lambdamikel/LambdaSpeak3/images/Computer_Shopper_-_December_2019-LS3.pdf

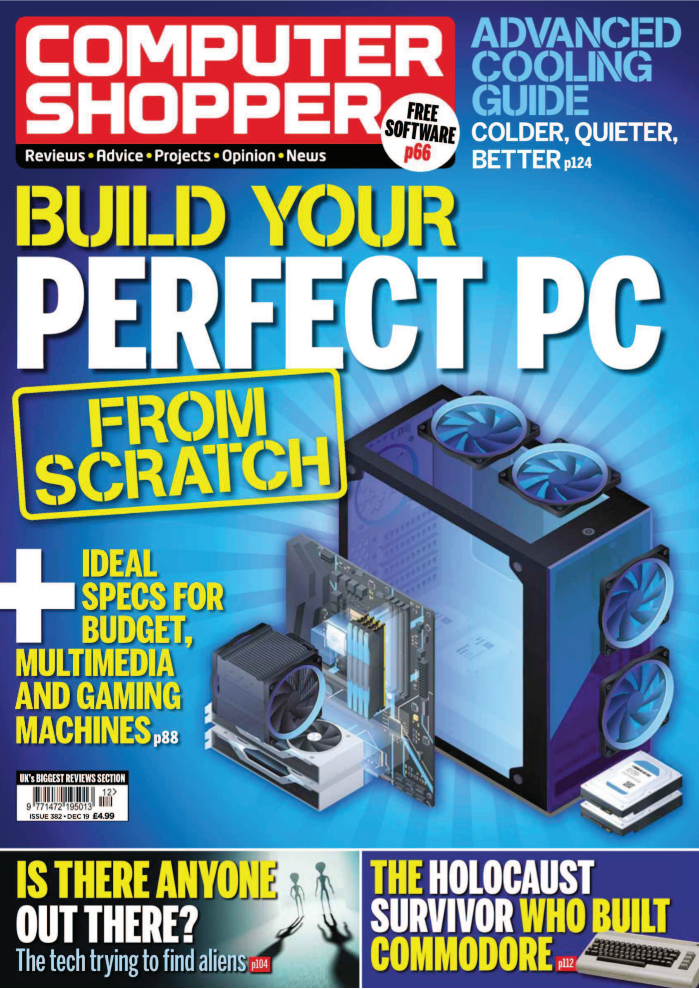
[picture p33: page 1]
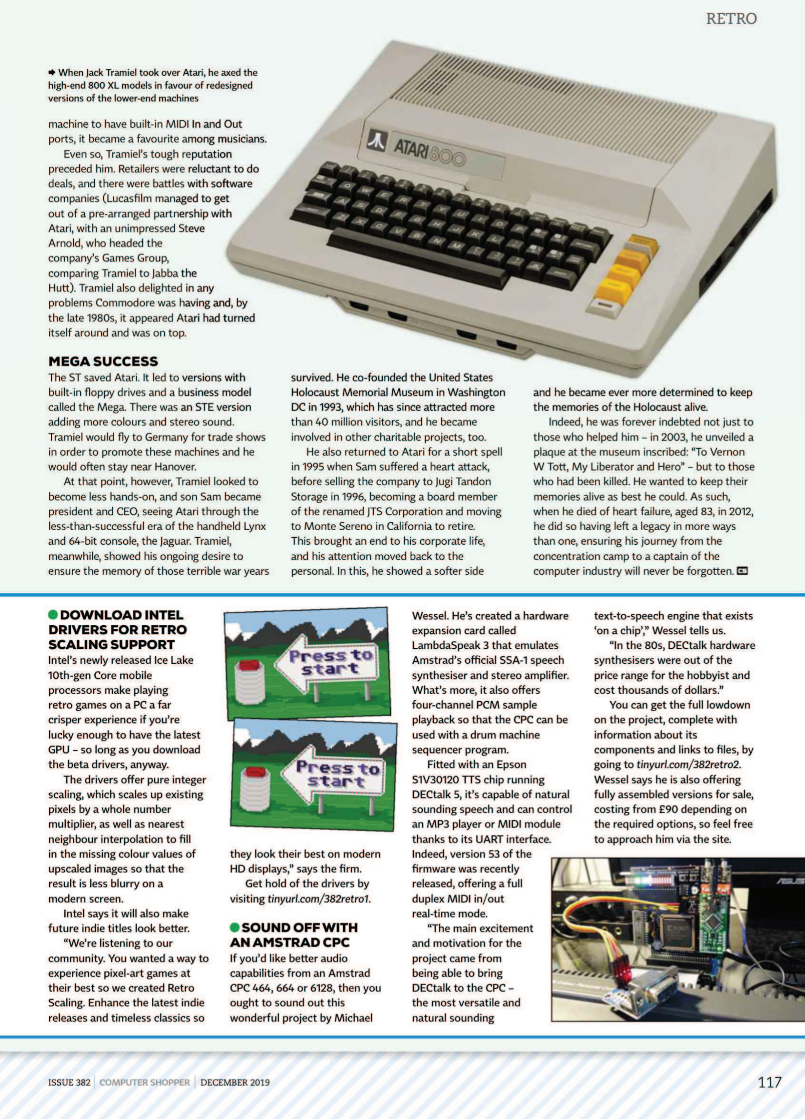
[picture p34: page 2]
