lambdamikel/LambdaSpeak3/articlepics/mycpc.jpg

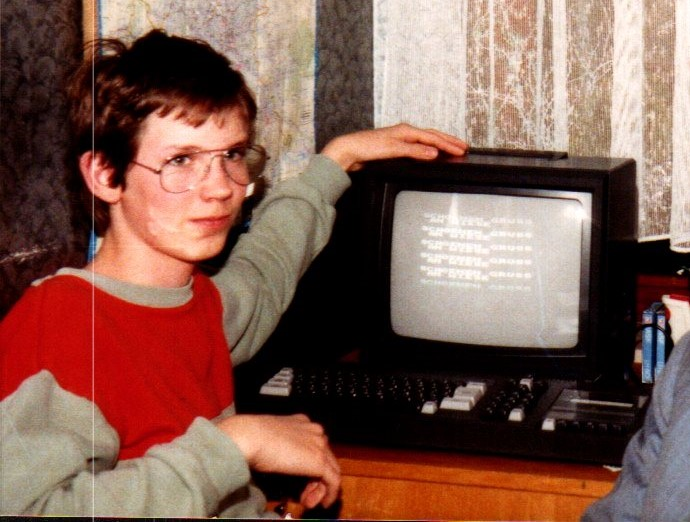
articlepics/mycpc.jpg
