lambdamikel/LambdaSpeak3/images/computershopper.jpg

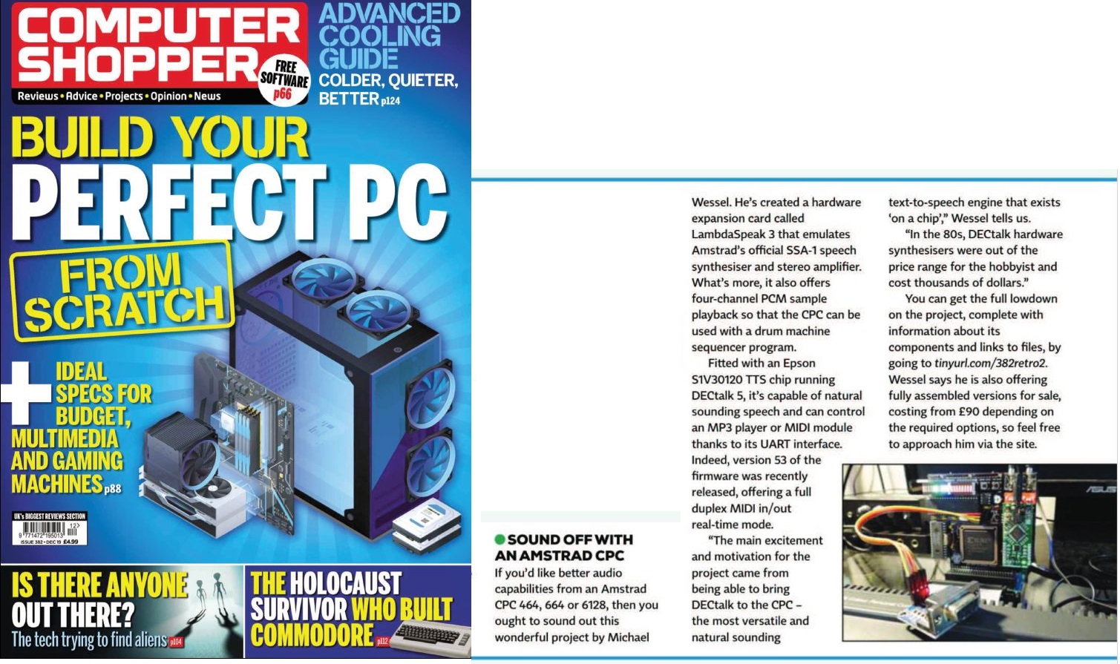
images/computershopper.jpg
