lambdamikel/LambdaSpeak3/images/DSC08523.JPG

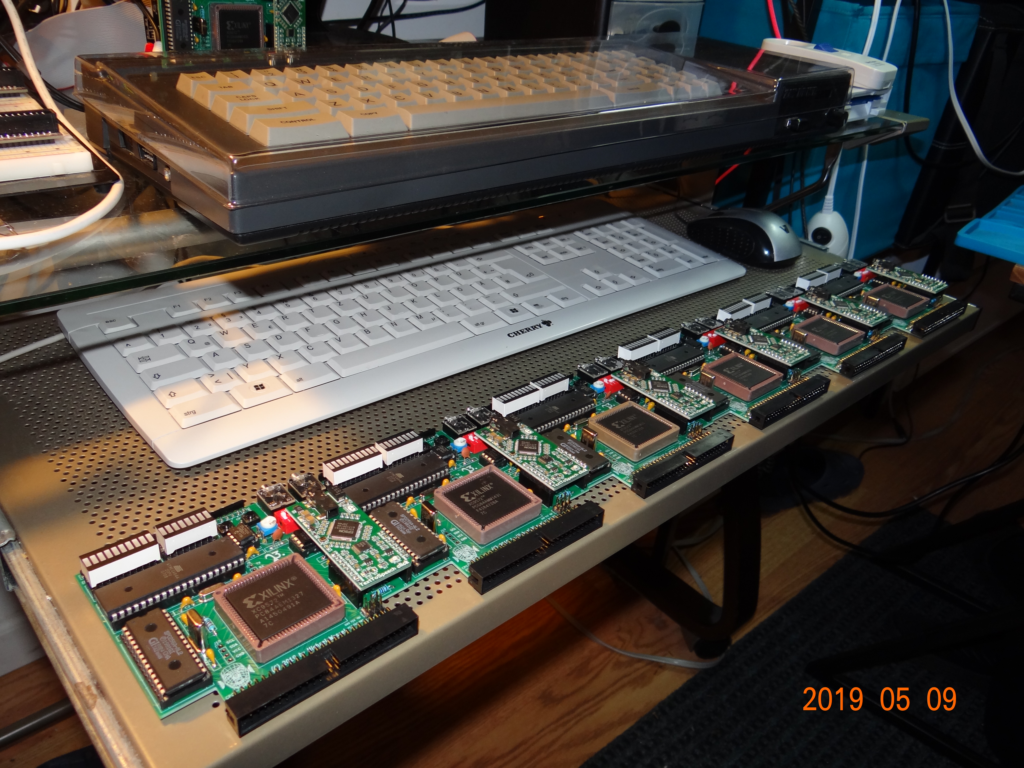
images/DSC08523.JPG
