lambdamikel/LambdaSpeak3/images/DSC08531.jpg

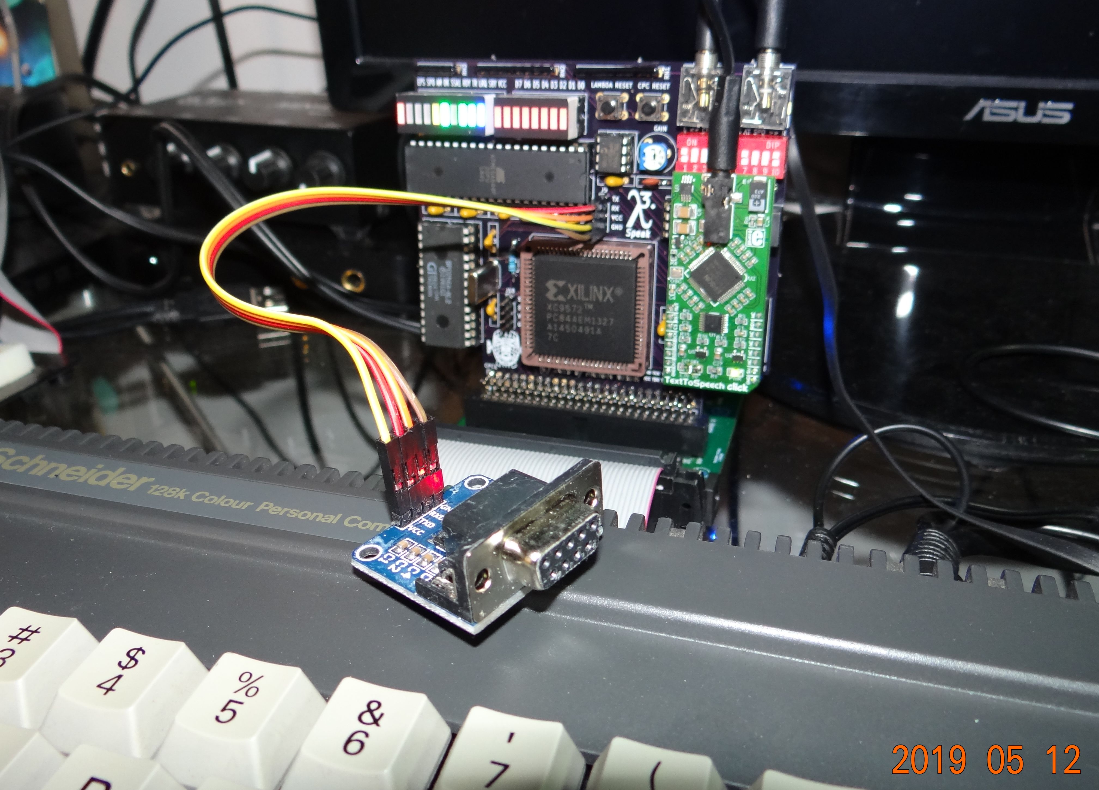
images/DSC08531.jpg
