lambdamikel/LambdaSpeak3/images/hackaday-ls3.jpg

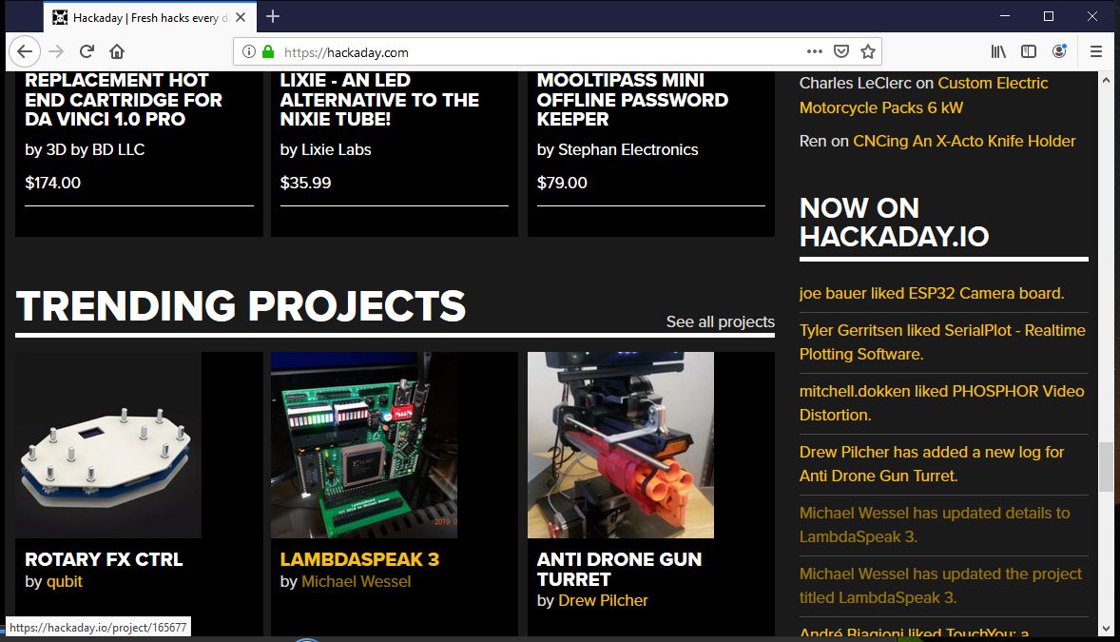
images/hackaday-ls3.jpg
