lambdamikel/LambdaSpeak3/images/lambdaspeak-z80-reset.jpg

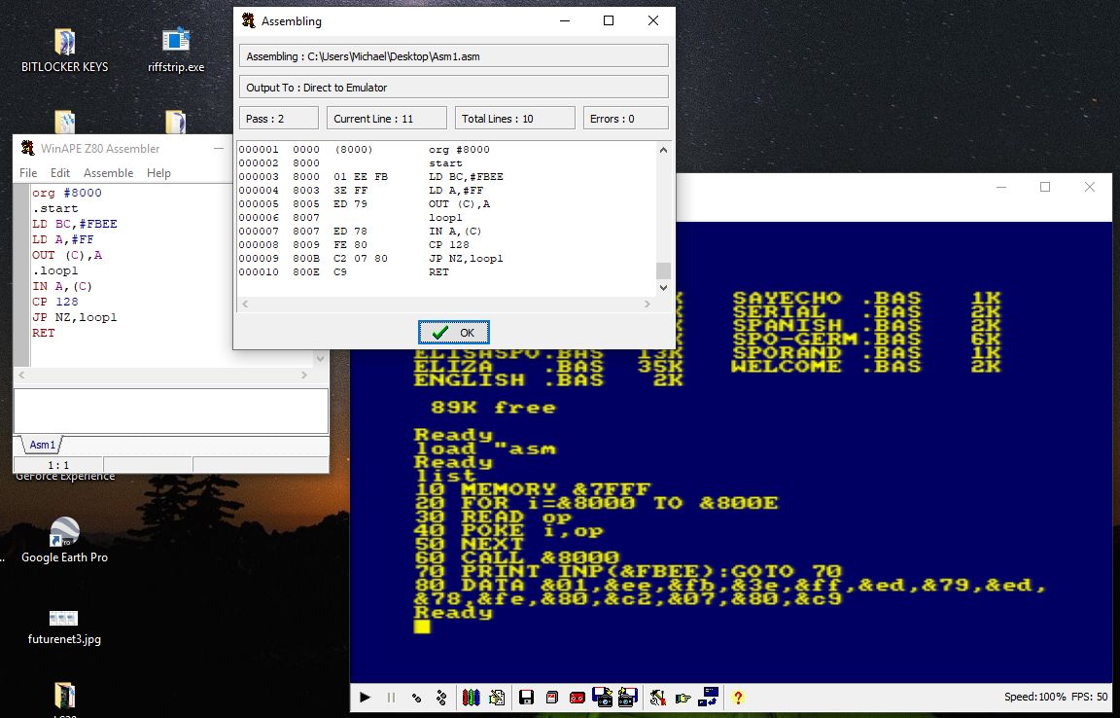
images/lambdaspeak-z80-reset.jpg
