lambdamikel/LambdaSpeak3/images/ls3-rtc-in-future-os.JPG

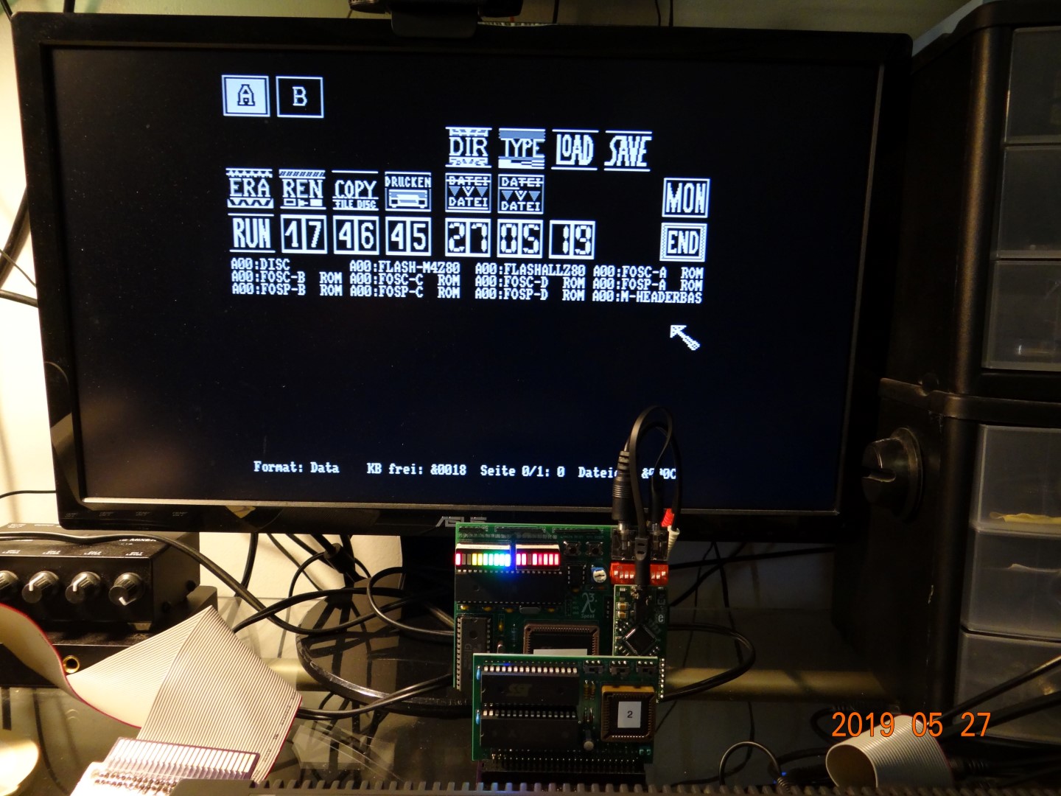
images/ls3-rtc-in-future-os.JPG
