lambdamikel/LambdaSpeak3/images/pcb-back.jpg

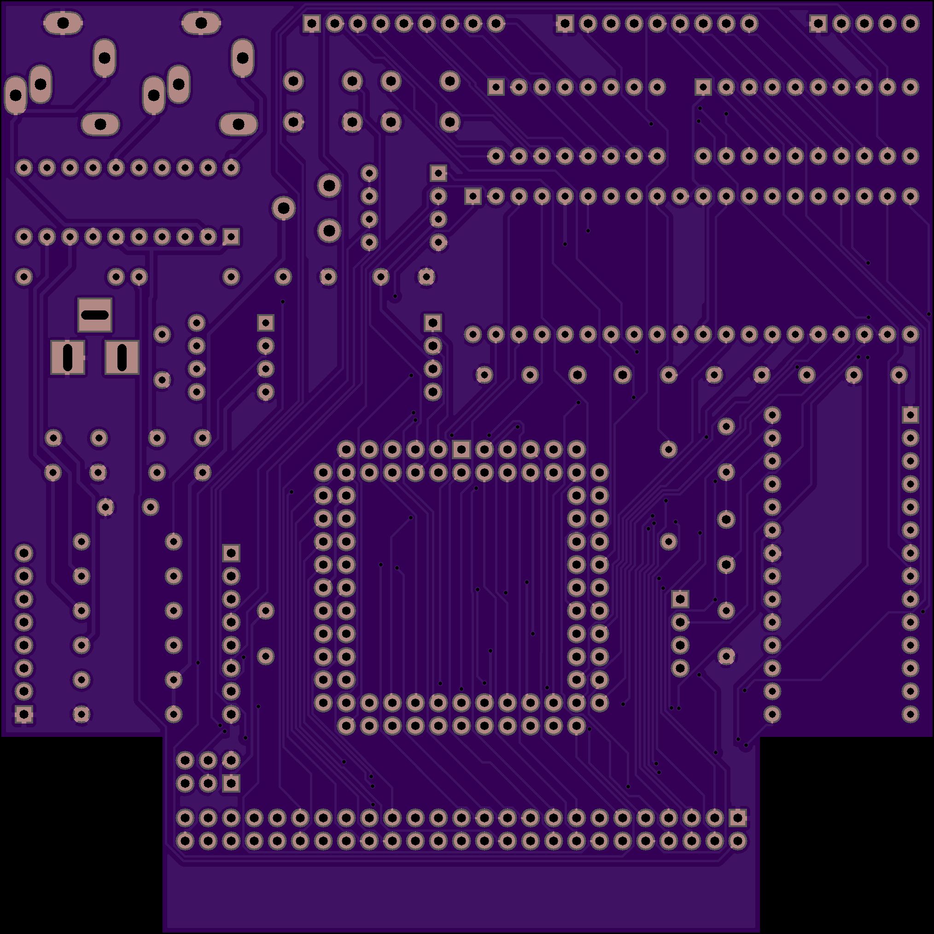
images/pcb-back.jpg
