lambdamikel/LambdaSpeak3/images/pcb-front.jpg

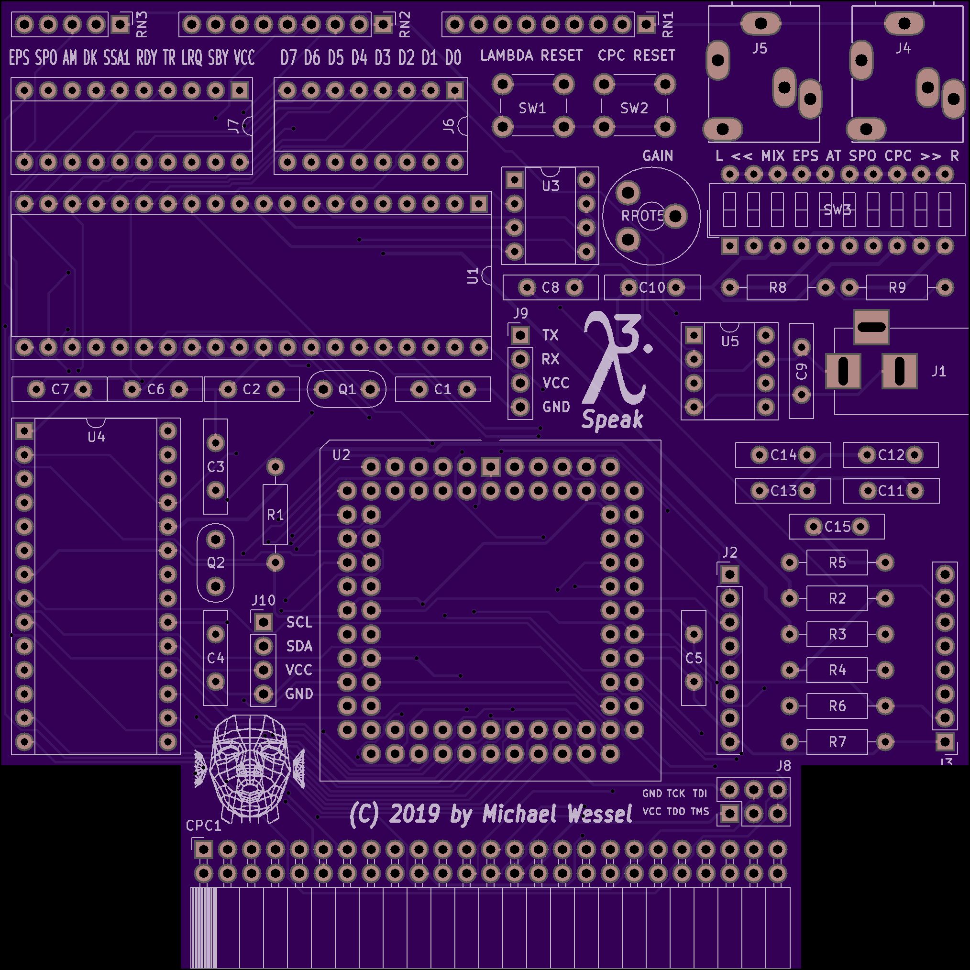
images/pcb-front.jpg
