lambdamikel/LambdaSpeak3/manuals/ls3-modes.pptx

RX / TX
IN OUT
MONITOR
SUB MODE

Reset Button,
Power Cycle

Serial Data OR
Control Byte =
255 + <byte>

SERIAL
MODE

&FF, 50

Serial Data OR
Control Byte =
255 + <byte>

&FF, 10

&F1

EPSON

RX
IN
MONITOR
SUB MODE

Don‘t Care
Input

AM-
DRUM

Streaming of PCM Bytes:
Byte -> PCM Audio

Receive Bytes:
> 127 : Control Byte
(change mode / setting)
<= 127 : Speech Content

Bytes: Hours,
Minutes, Seconds, …

SET RTC

&FF, &14

Return to
previous mode!

&E3

DECtalk

  1. modes in this group pairwise mutally reachable
  2. not all modes support all control bytes

&FF

&EF

SSA1 EMU

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
SSA1
SPO

End of mode / EOM
(all bytes received)

End of mode / EOM
(all bytes received)

Receive Bytes:
Address,
Sample Length,
then PCM Bytes
to store in EEPROM

&E1

&E2

&FA - &FD

PCM PLAY

Receive
PCM Play Commands:
Channel, Page, Pitch, Speed

PCM UPLOAD

&F1

Channel &FF
-> EXIT, return to
previous mode
