lambdamikel/LambdaSpeak3/manuals/ls3-modes.pdf

&E3

&F1

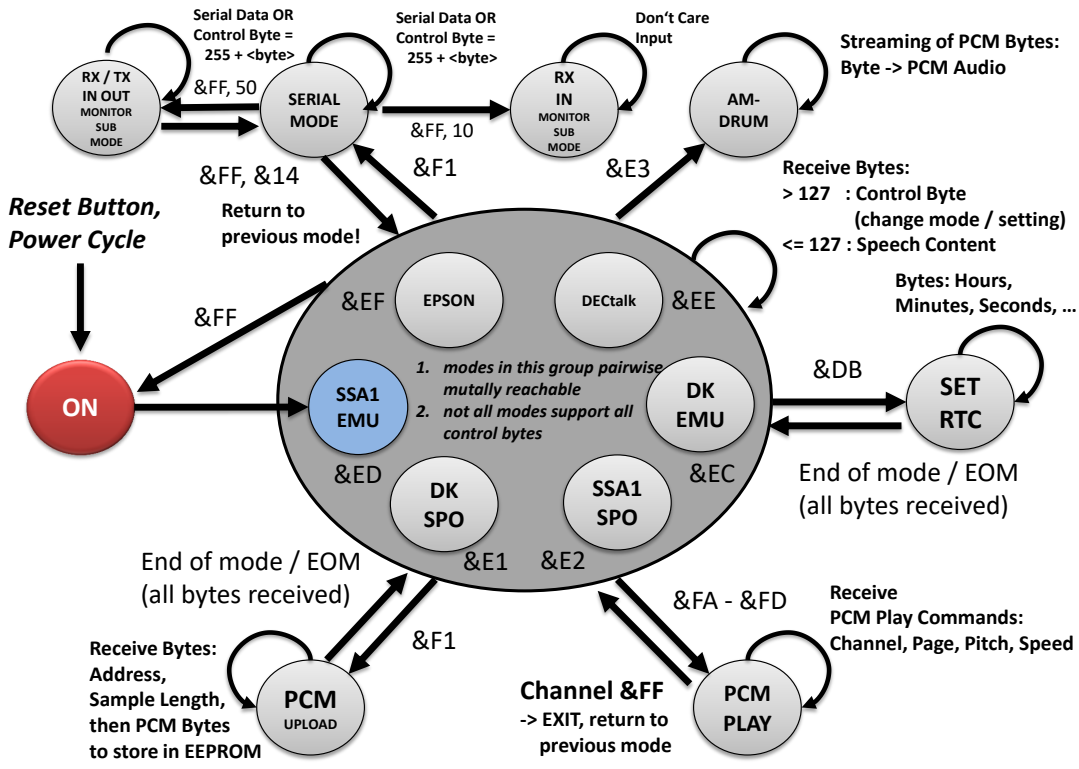
[picture p52: page 1]
SSA1 EMU ON; EPSON; DK EMU; DECtalk; AM- DRUM; SERIAL MODE; PCM; UPLOAD; PCM PLAY; DK SPO; SSA1 SPO; SET RTC; Reset Button, Power Cycle; Receive Bytes: > 127 : Control Byte; <= 127 : Speech Content; Don‘t Care Input; Bytes: Hours, Minutes, Seconds, …; Return to previous mode!; RX / TX IN OUT; MONITOR SUB MODE

Serial Data OR
Control Byte =
255 + <byte>

Streaming of PCM Bytes:
Byte -> PCM Audio

(change mode / setting)

1. modes in this group pairwise
mutally reachable
2. not all modes support all
control bytes

End of mode / EOM
(all bytes received)

Receive
PCM Play Commands:
Channel, Page, Pitch, Speed

Receive Bytes:
Address,
Sample Length,
then PCM Bytes
to store in EEPROM

Channel &FF
-> EXIT, return to
previous mode
