lambdamikel/LambdaSpeak3/schematics/schematics-bw.pdf

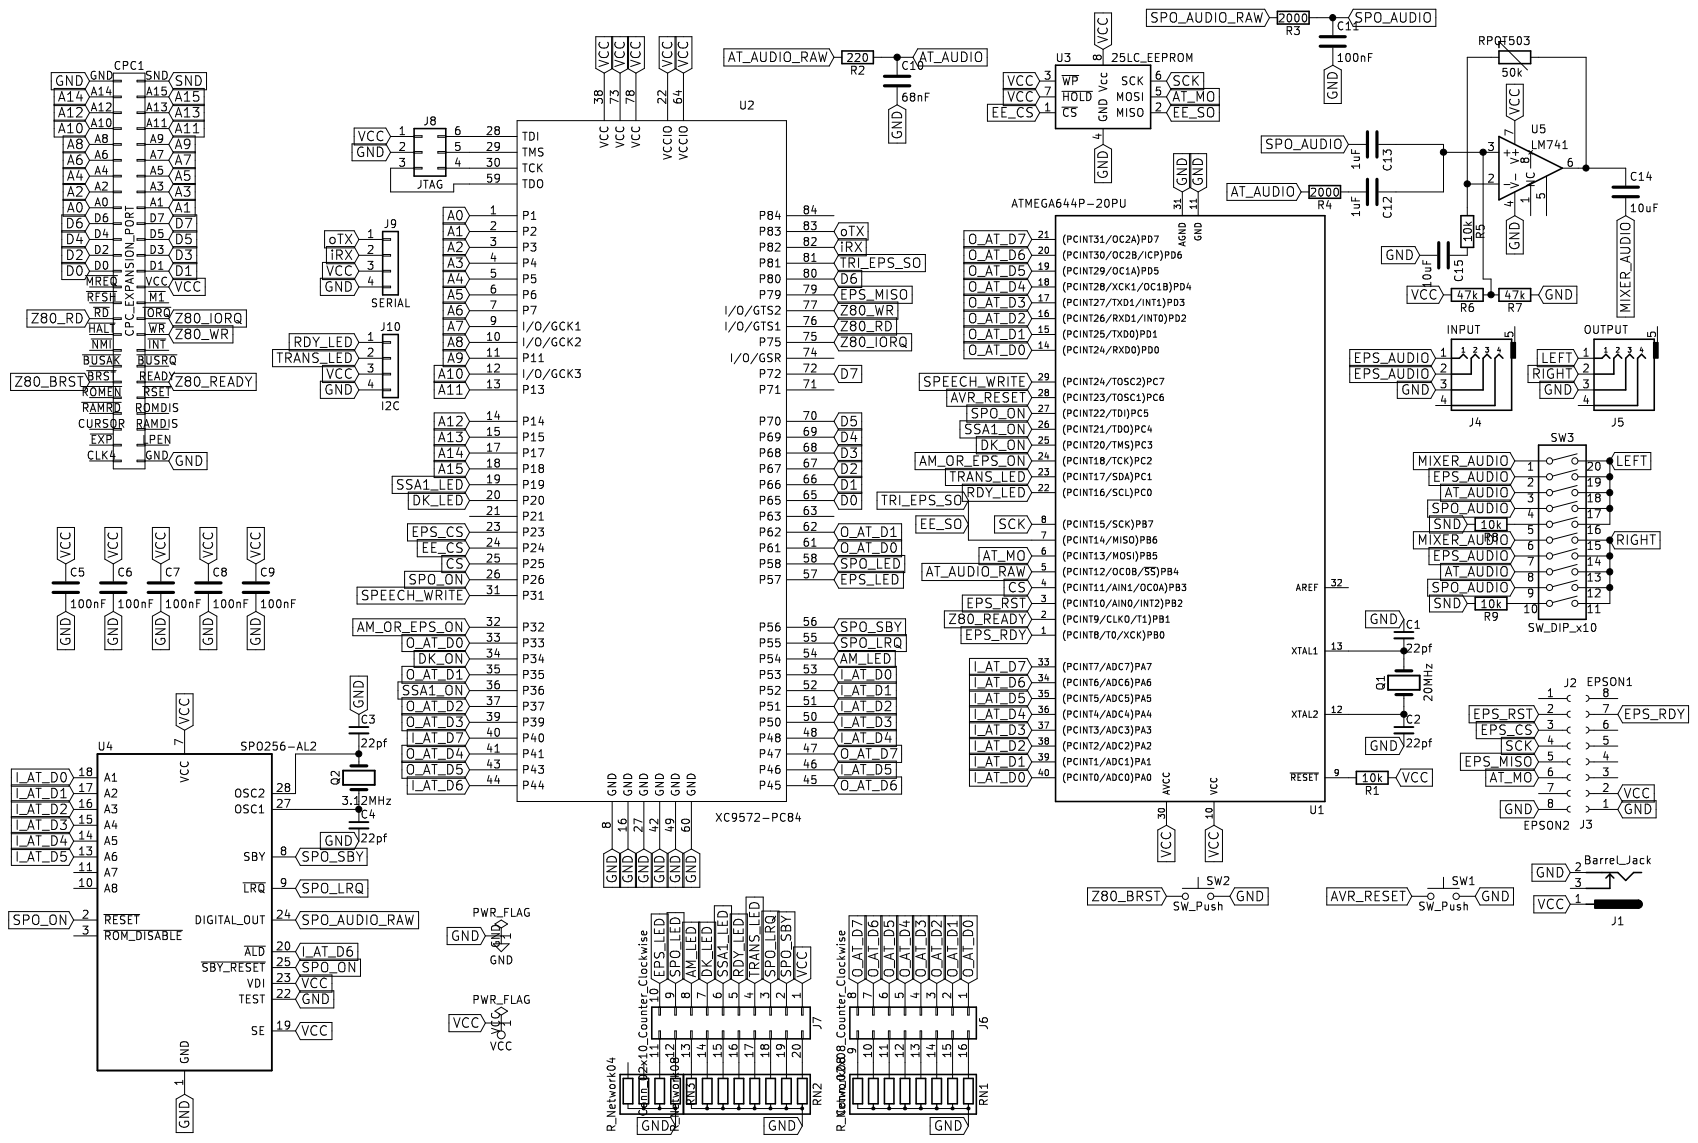
[picture p53: page 1]
