lambdamikel/LambdaSpeak3/schematics/schematics.pdf

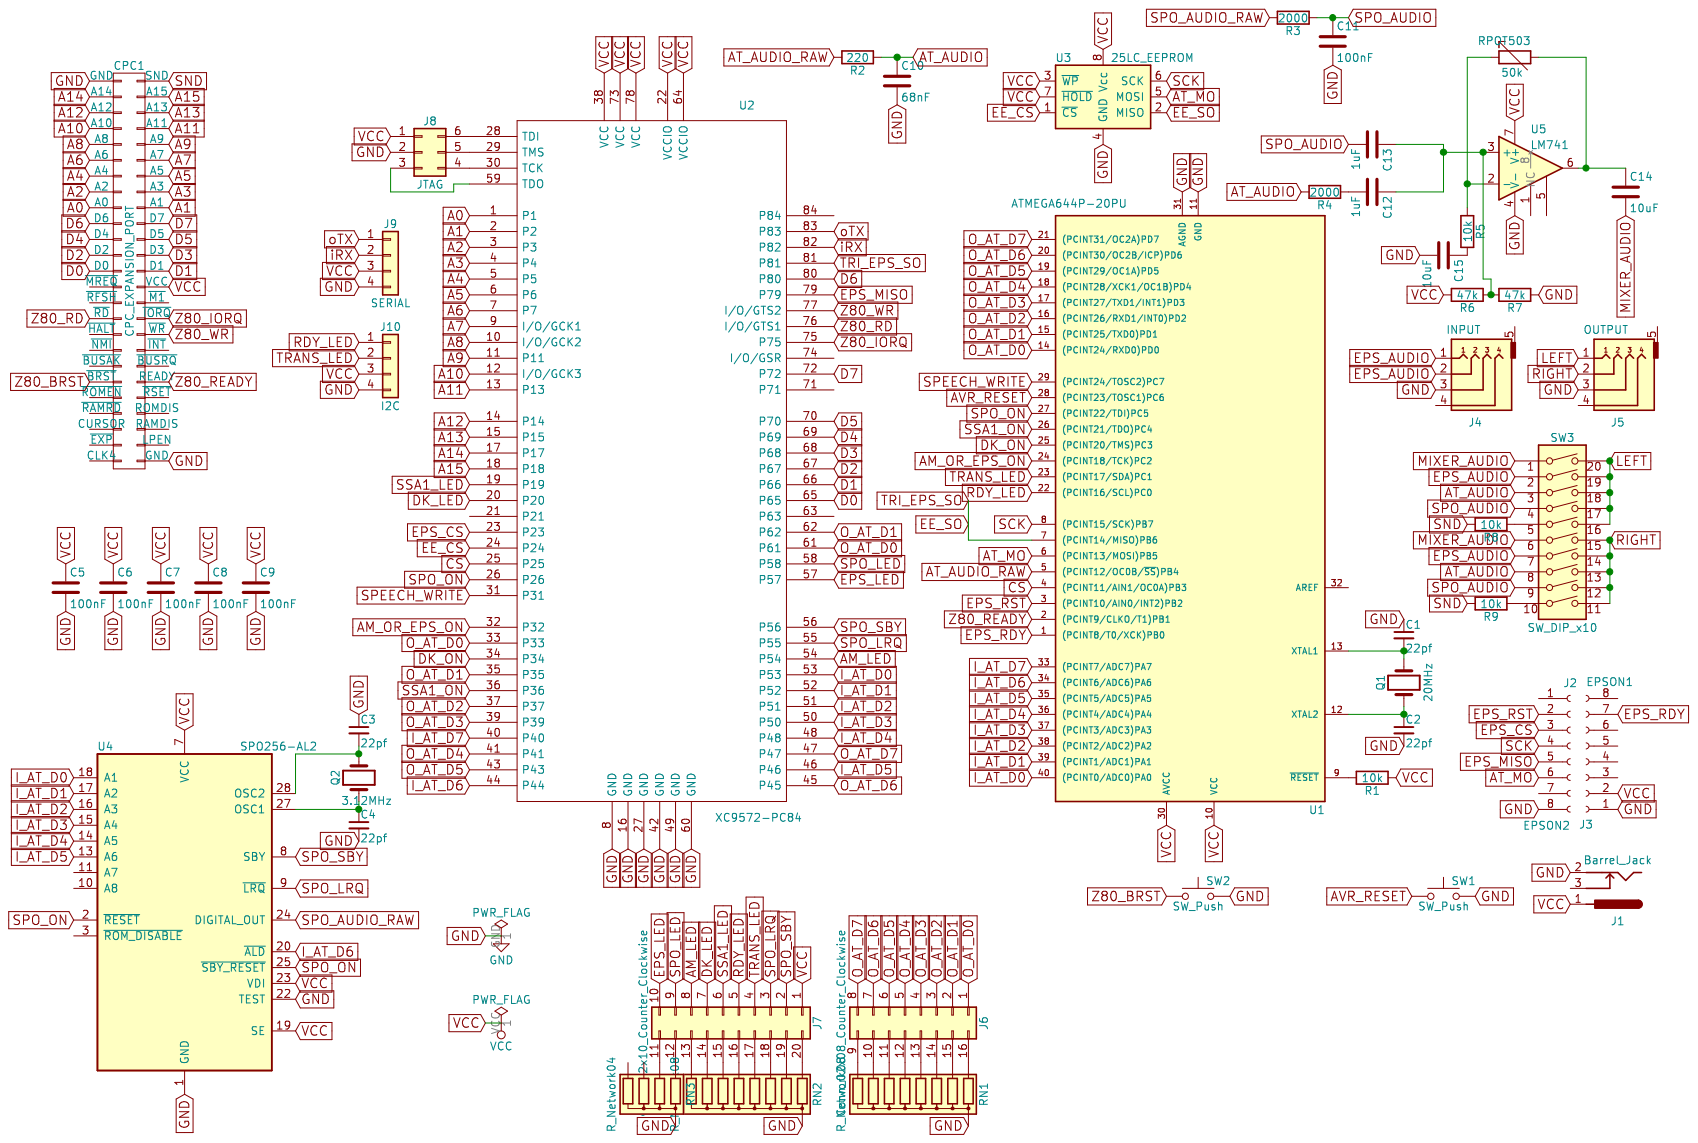
[picture p54: page 1]
