lambdamikel/LambdaSpeak3/Giving The Amstrad CPC A Voice And A Drum Kit _ Hackaday.pdf

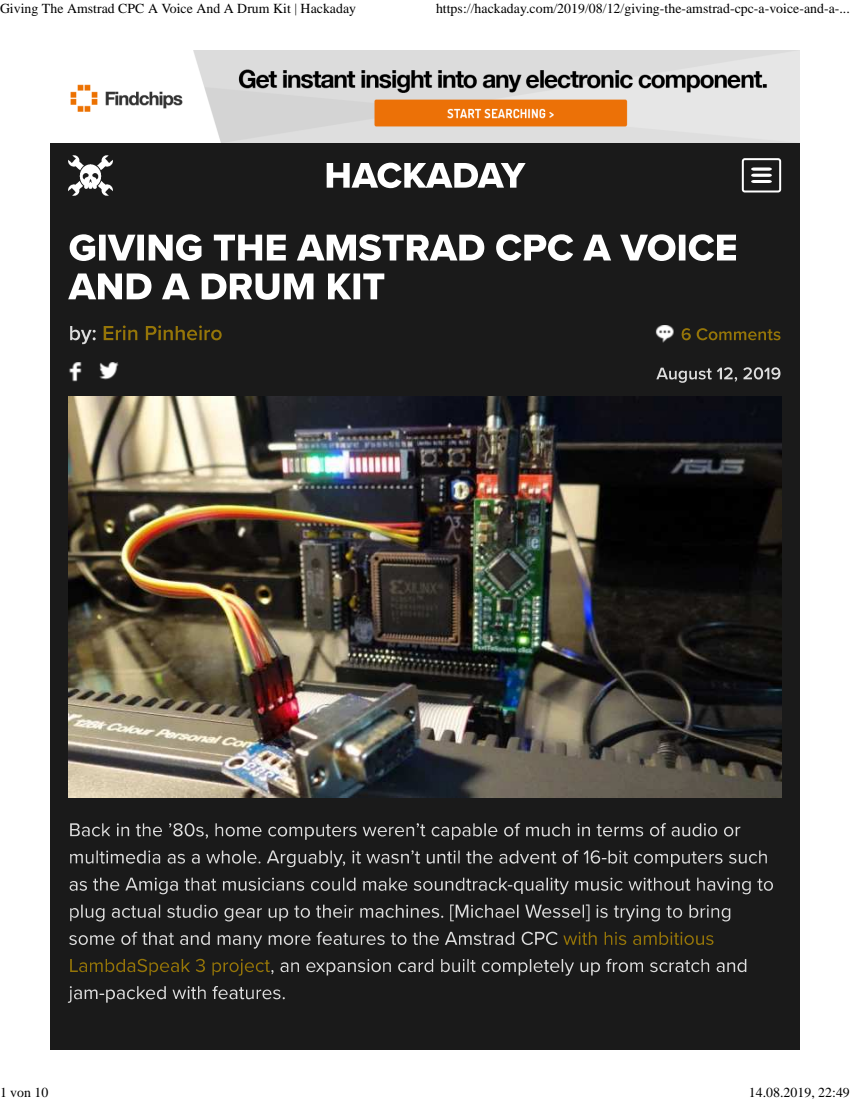
[picture p55: page 1]
Giving The Amstrad CPC A Voice And A Drum Kit | Hackaday; https://hackaday.com/2019/08/12/giving-the-amstrad-cpc-a-voice-and-a-...; 1 von 10

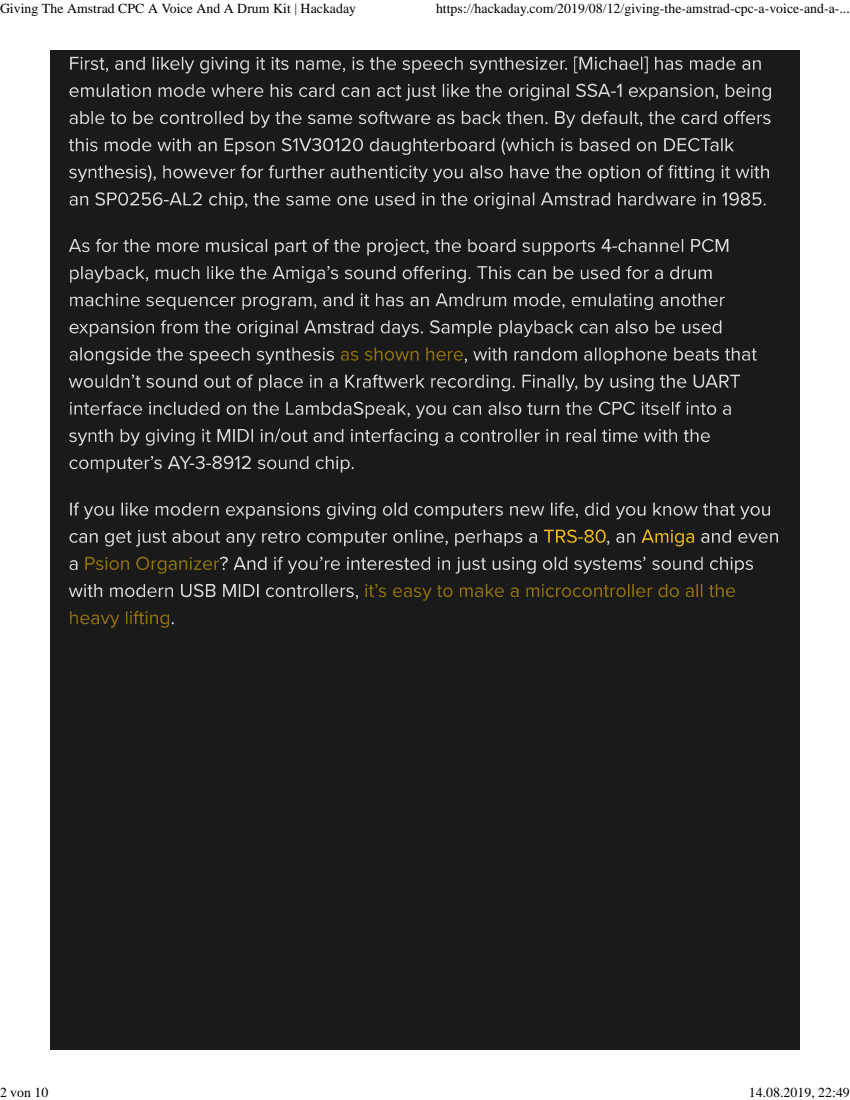
[picture p56: page 2]

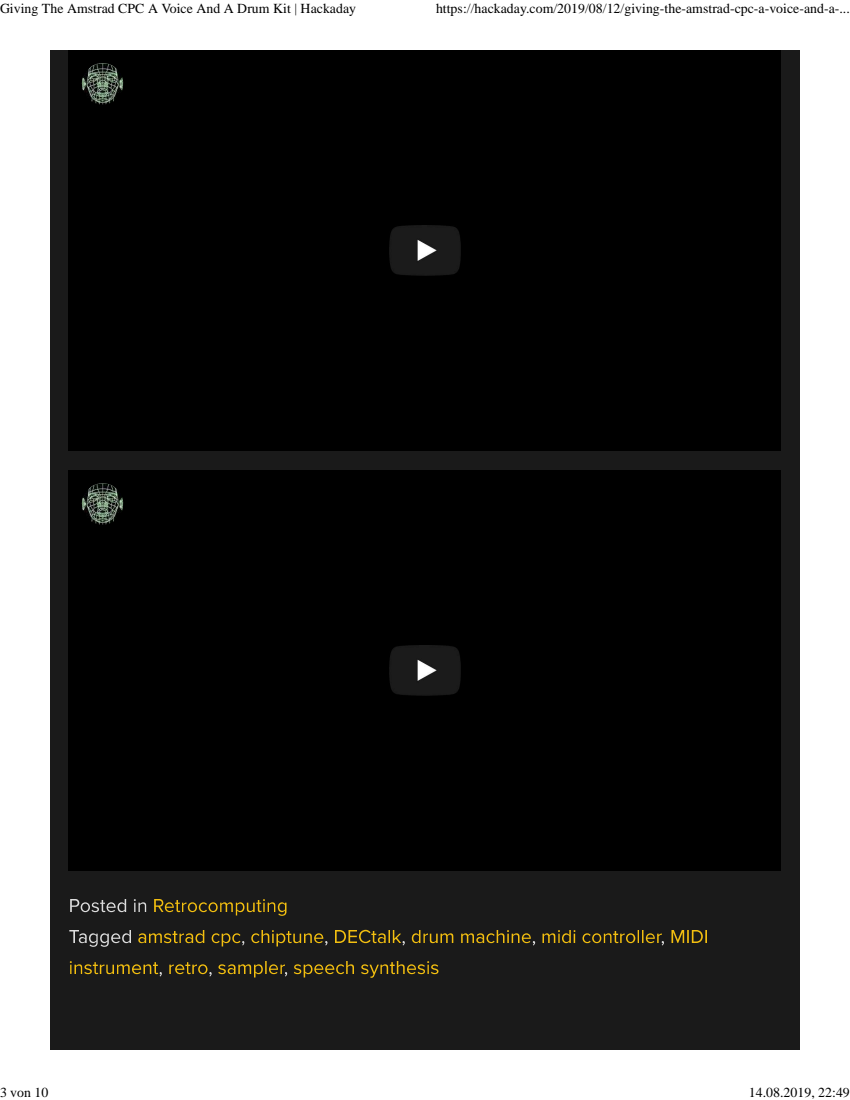
[picture p57: page 3]

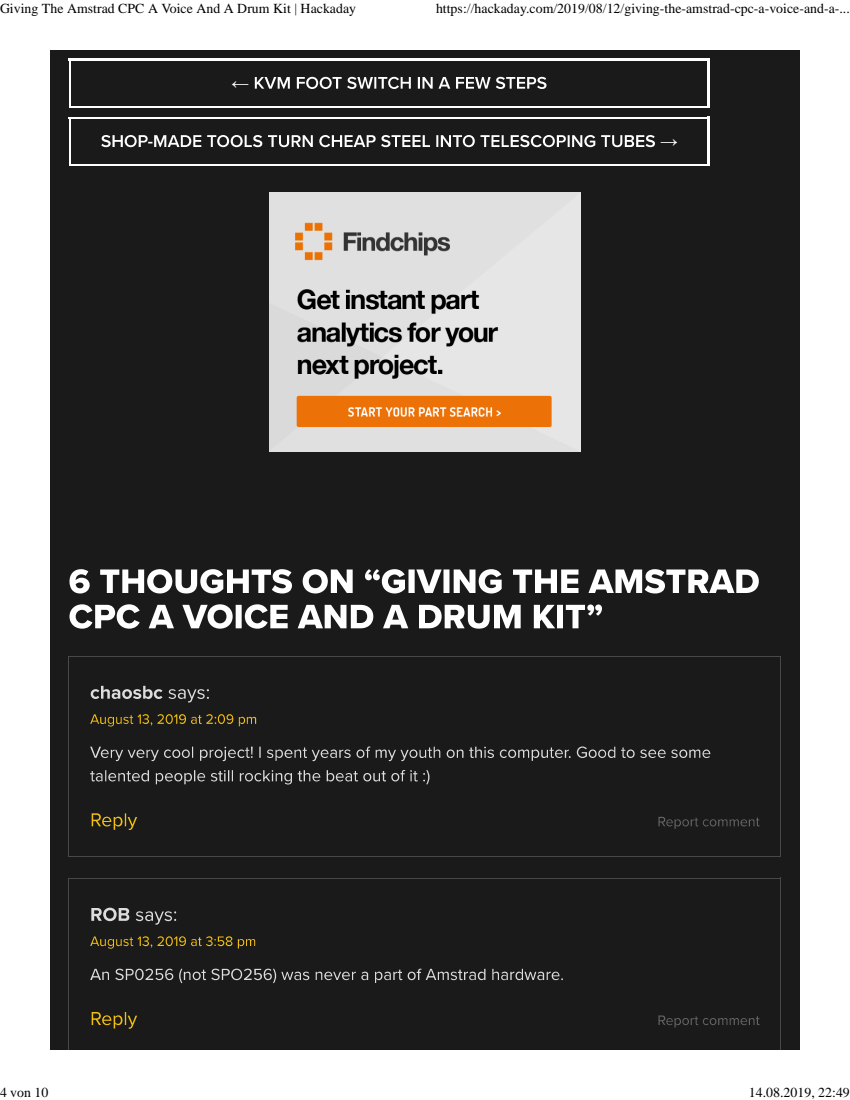
[picture p58: page 4]

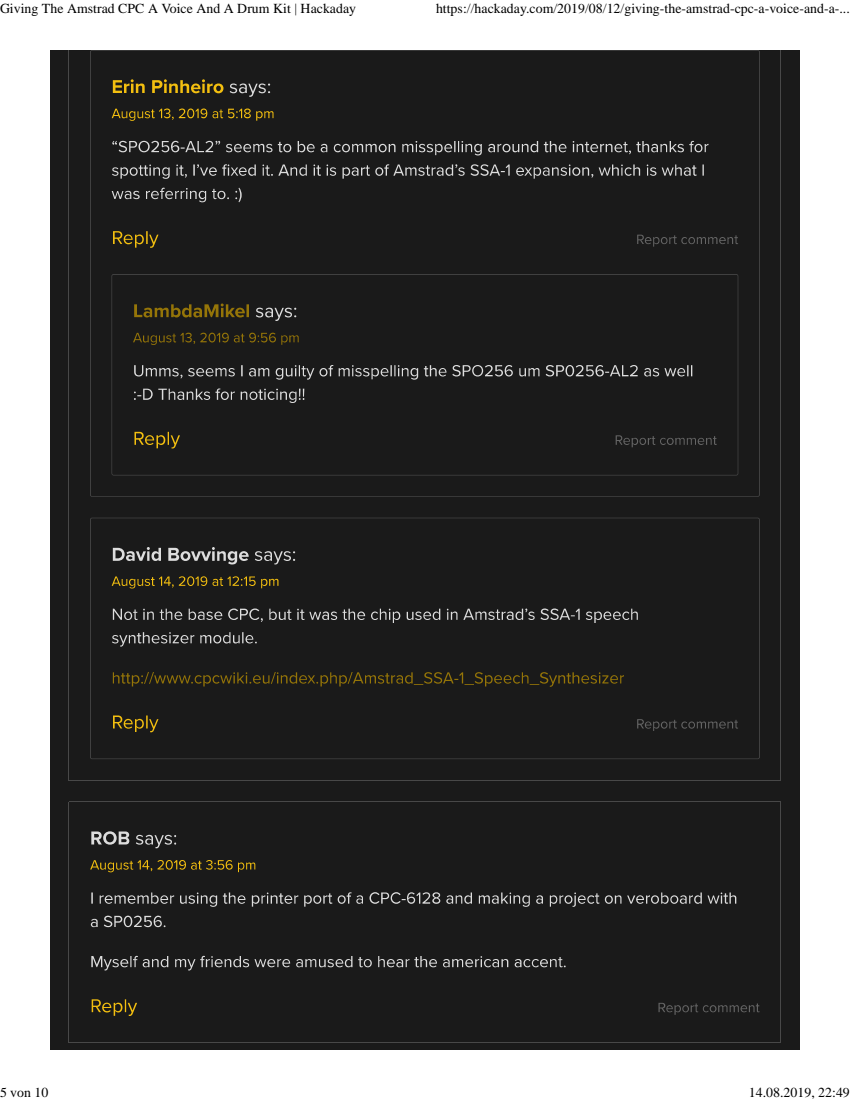
[picture p59: page 5]

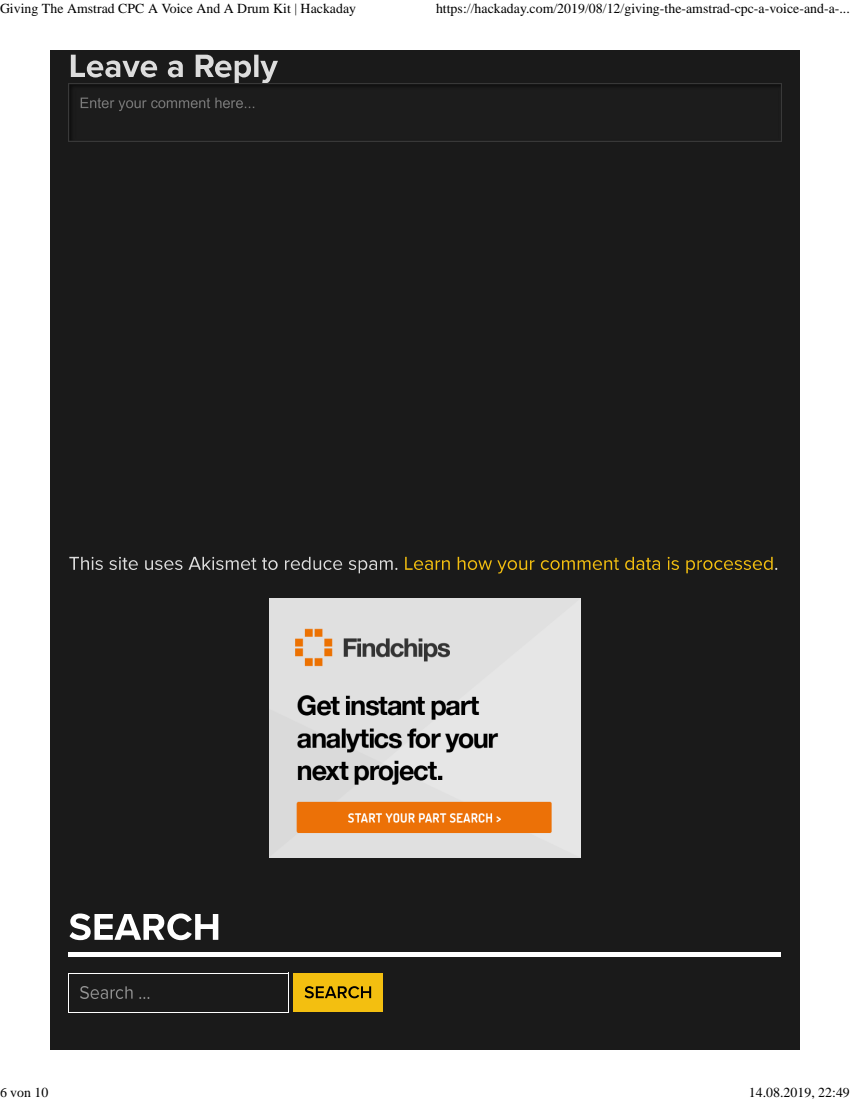
[picture p60: page 6]

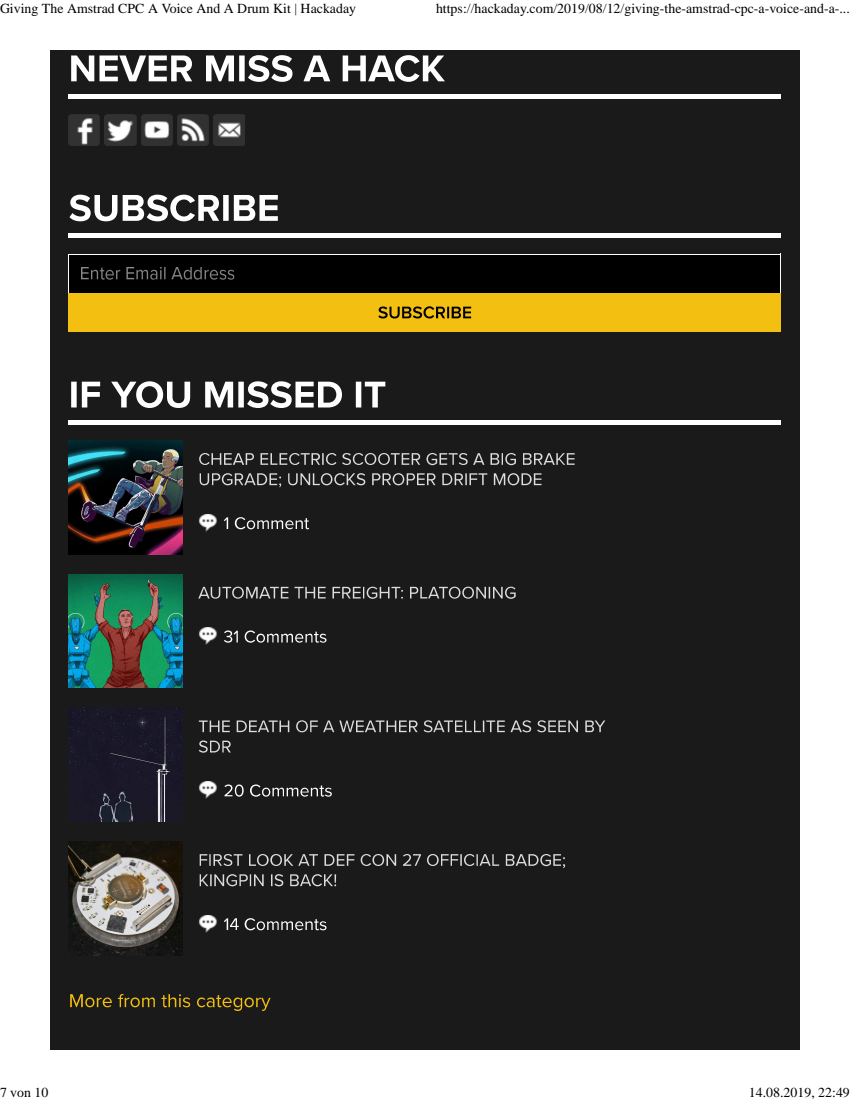
[picture p61: page 7]

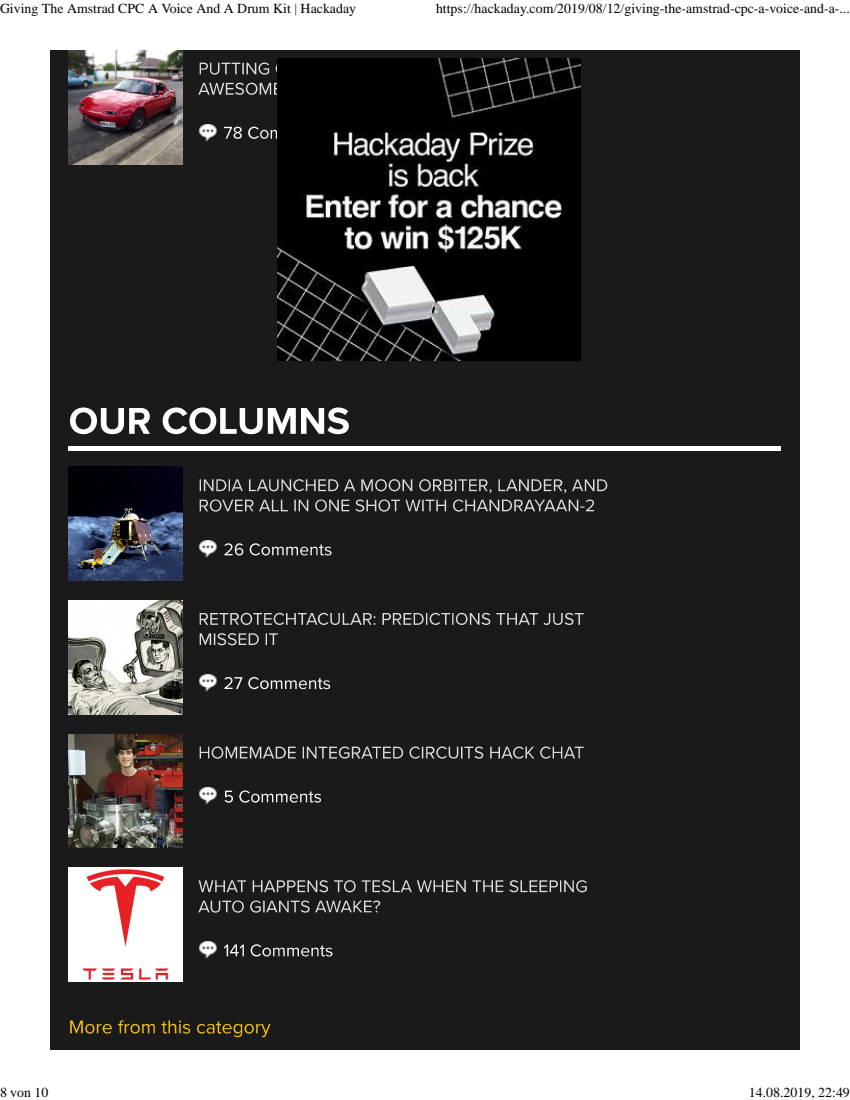
[picture p62: page 8]

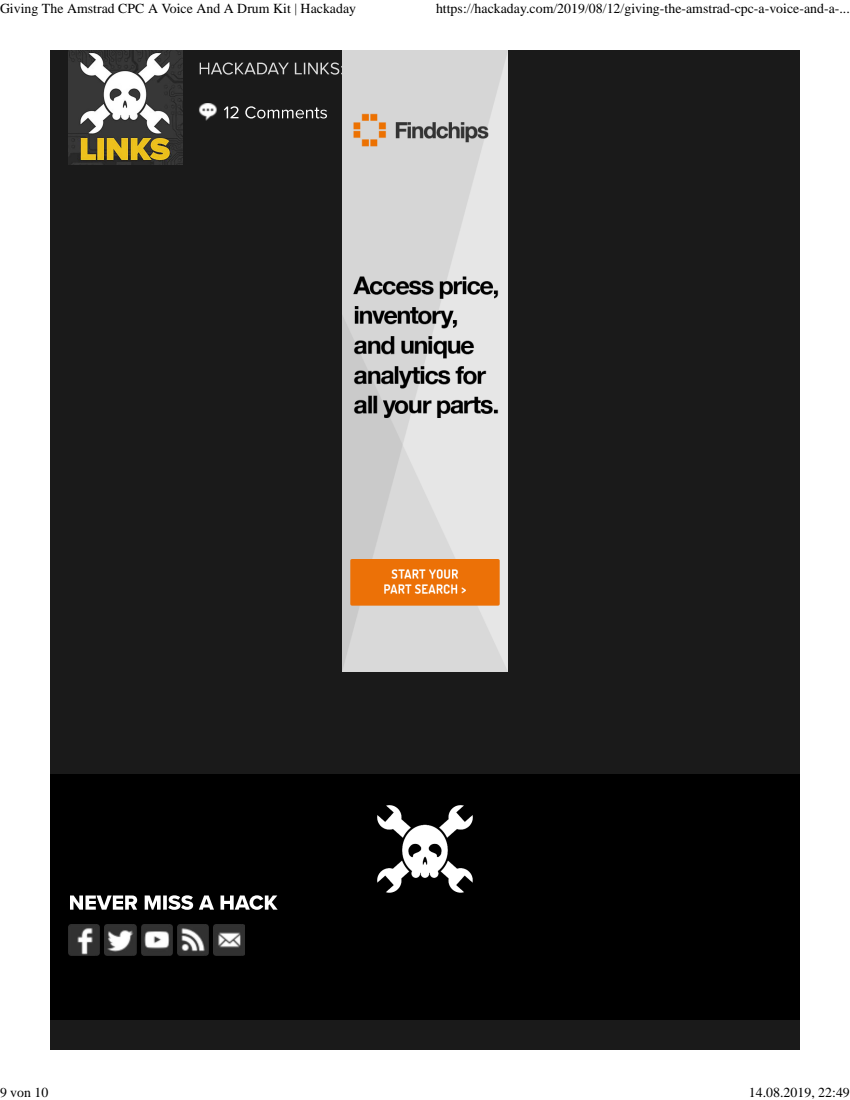
[picture p63: page 9]
