lambdamikel/LambdaSpeak3/src/atmega644-20pu/pcm.h

const long pcm_length=13191;

const unsigned char pcm_samples[] PROGMEM =
{
	127,128,127,121,122,127,129,128,127,125,125,128,128,128,127,128,128,129,128,128,125,126,124,123,124,122,125,125,126,120,120,127,128,127,121,120,120,122,125,125,124,125,124,121,118,116,122,126,122,125,121,123,127,129,134,134,128,126,127,128,123,115,121,129,131,128,126,129,135,133,127,121,120,125,129,129,127,119,120,128,134,130,117,108,117,131,139,126,111,114,126,136,134,126,
	126,125,133,141,138,130,127,131,144,144,127,114,117,130,133,127,128,128,127,131,133,129,126,126,127,126,128,126,121,120,129,134,131,124,113,119,131,135,132,125,121,127,134,133,126,112,115,128,139,132,113,114,126,141,150,140,125,115,124,136,138,128,116,113,119,127,133,127,116,112,113,119,129,129,122,114,119,133,143,139,122,111,115,124,127,127,125,120,123,130,132,121,115,119,131,143,135,124,123,130,
	142,140,126,110,112,128,133,128,125,126,130,136,129,107,96,118,151,152,126,95,89,118,146,157,146,134,126,138,157,136,95,84,117,161,171,101,105,206,200,94,47,59,77,122,146,158,152,153,169,165,145,114,94,105,131,137,130,125,127,131,130,116,100,100,118,137,149,146,133,128,127,132,130,114,100,111,135,155,147,125,117,126,135,132,120,111,115,127,127,112,103,121,136,141,128,111,110,122,137,140,
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

};
