lambdamikel/LambdaSpeak3/src/atmega644-20pu/pcm2.h

const long pcm_length=8756;

const unsigned char pcm_samples[] PROGMEM = {
127, 128, 128, 128, 127, 127, 126, 127, /* 0-7 */
127, 128, 128, 128, 128, 128, 127, 128, /* 8-15 */
127, 127, 130, 132, 133, 136, 137, 138, /* 16-23 */
141, 142, 142, 144, 144, 145, 147, 146, /* 24-31 */
146, 149, 152, 153, 154, 153, 155, 155, /* 32-39 */
156, 157, 157, 166, 165, 164, 166, 163, /* 40-47 */
165, 165, 168, 170, 176, 181, 184, 187, /* 48-55 */
185, 185, 185, 185, 187, 191, 190, 191, /* 56-63 */
192, 191, 193, 191, 192, 194, 192, 192, /* 64-71 */
191, 189, 187, 185, 185, 185, 188, 190, /* 72-79 */
194, 198, 200, 198, 195, 180, 176, 175, /* 80-87 */
171, 171, 169, 168, 166, 163, 161, 160, /* 88-95 */
156, 150, 148, 145, 133, 123, 113, 106, /* 96-103 */
104, 102,  99, 102, 102, 105, 103, 100, /* 104-111 */
 96,  86,  81,  78,  76,  72,  68,  68, /* 112-119 */
 77,  75,  73,  71,  71,  74,  82,  89, /* 120-127 */
 89,  84,  85,  86,  91,  91,  93,  97, /* 128-135 */
 82,  75,  94,  97,  93,  92,  89,  87, /* 136-143 */
 90,  92,  97, 108, 104,  95,  97,  93, /* 144-151 */
100, 128, 129, 116, 118, 114, 117, 121, /* 152-159 */
117, 119, 119, 120, 137, 156, 160, 149, /* 160-167 */
132, 107,  86,  97, 100,  90,  99, 101, /* 168-175 */
 96,  90,  87,  79,  67,  56,  45,  46, /* 176-183 */
 45,  46,  69,  68,  47,  61,  69,  65, /* 184-191 */
 75,  81,  82,  81,  79,  88,  92,  90, /* 192-199 */
 92, 104, 127, 116, 114, 128, 118, 123, /* 200-207 */
131, 135, 120, 116, 118, 117, 122, 111, /* 208-215 */
 95,  82,  81,  95, 128, 138, 125, 130, /* 216-223 */
124, 122, 119, 117, 103,  97, 136, 174, /* 224-231 */
174, 180, 178, 171, 161, 148, 157, 160, /* 232-239 */
153, 158, 172, 180, 168, 156, 158, 159, /* 240-247 */
157, 177, 190, 184, 179, 178, 180, 164, /* 248-255 */
150, 149, 160, 163, 161, 159, 154, 140, /* 256-263 */
138, 136, 130, 129, 125, 113,  89,  81, /* 264-271 */
 81,  83,  86,  84,  88,  96, 100,  98, /* 272-279 */
 91,  75,  64,  59,  51,  54,  83, 103, /* 280-287 */
 93,  84,  85,  88,  95,  96,  81,  74, /* 288-295 */
 78,  90, 102,  97,  86,  77,  75,  64, /* 296-303 */
 64,  78,  79,  78,  75,  72,  71,  67, /* 304-311 */
 53,  43,  53,  73,  80,  82,  84,  91, /* 312-319 */
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
