lambdamikel/LambdaSpeak3/src/atmega644-20pu/pcm3.h

const long pcm_length=5853;

const unsigned char pcm_samples[] PROGMEM = {
128, 128, 128, 128, 129, 128, 128, 127, /* 0-7 */
127, 127, 128, 128, 127, 127, 127, 127, /* 8-15 */
128, 128, 127, 128, 128, 128, 128, 127, /* 16-23 */
127, 128, 127, 127, 126, 127, 128, 126, /* 24-31 */
126, 126, 126, 127, 126, 125, 126, 127, /* 32-39 */
129, 127, 125, 126, 126, 127, 125, 124, /* 40-47 */
125, 125, 126, 125, 126, 128, 126, 126, /* 48-55 */
126, 129, 130, 127, 126, 127, 129, 128, /* 56-63 */
125, 124, 129, 128, 128, 128, 125, 128, /* 64-71 */
129, 129, 129, 123, 125, 129, 128, 128, /* 72-79 */
126, 121, 129, 128, 127, 128, 124, 127, /* 80-87 */
126, 124, 128, 125, 123, 126, 125, 127, /* 88-95 */
127, 125, 127, 124, 123, 126, 125, 126, /* 96-103 */
127, 126, 129, 129, 126, 128, 128, 128, /* 104-111 */
128, 126, 129, 130, 127, 128, 131, 131, /* 112-119 */
133, 129, 127, 132, 127, 131, 130, 122, /* 120-127 */
128, 127, 130, 132, 123, 125, 130, 131, /* 128-135 */
130, 123, 121, 128, 128, 127, 127, 123, /* 136-143 */
128, 127, 128, 131, 124, 127, 127, 129, /* 144-151 */
131, 124, 128, 130, 130, 131, 129, 129, /* 152-159 */
132, 131, 132, 132, 131, 128, 127, 132, /* 160-167 */
136, 132, 126, 128, 132, 136, 131, 125, /* 168-175 */
126, 127, 131, 129, 125, 125, 124, 131, /* 176-183 */
129, 128, 132, 127, 125, 126, 129, 131, /* 184-191 */
125, 121, 128, 124, 127, 128, 125, 129, /* 192-199 */
125, 127, 131, 128, 127, 128, 126, 129, /* 200-207 */
126, 127, 134, 127, 125, 126, 129, 135, /* 208-215 */
127, 121, 124, 127, 131, 128, 123, 124, /* 216-223 */
128, 131, 131, 127, 122, 127, 131, 126, /* 224-231 */
120, 112, 123, 131, 124, 107, 101, 160, /* 232-239 */
190, 158, 132, 139, 172, 160, 117, 107, /* 240-247 */
103, 105, 110, 103, 103, 105, 103, 112, /* 248-255 */
134, 143, 129, 115, 119, 128, 141, 139, /* 256-263 */
119, 114, 121, 143, 152, 136, 127, 123, /* 264-271 */
133, 148, 143, 134, 124, 122, 131, 133, /* 272-279 */
137, 118, 104, 107, 109, 151, 159, 125, /* 280-287 */
109, 109, 140, 147, 122, 109, 104, 114, /* 288-295 */
132, 127, 122, 110, 100,  99, 121, 165, /* 296-303 */
151, 119, 106, 135, 168, 138, 116, 108, /* 304-311 */
113, 134, 136, 120, 110, 107, 125, 152, /* 312-319 */
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
