lambdamikel/LambdaSpeak3/(commit log)

2019-05-03 Added control bytes for documentation, and UART interpreter loop.
2019-05-03 PCB images.
2019-05-03 Adding annotated LS 3.0 board picture.
2019-05-05 Bugfix LEDs LS3 firmware.
2019-05-05 Bugfix LS3 firmware. Status LEDs.
    [lambdaspeak3.v]
2019-05-05 LS3 ATmega firmware update / bugfix status LEDs.
2019-05-05 Description of LS3 mode indicator LEDs.
2019-05-05 LED description.
2019-05-15 README.md mention KiCad and freeRouting.jar.
2019-05-15 README.md mention KiCad and freeRouting.jar
2019-05-17 README.md document UART command / control bytes table.
2019-05-17 README.md UART mode control bytes / commands tabe.
2019-05-17 README.md UART mode description update.
2019-05-18 README.md UART command table.
2019-06-09 TFM's latest LambdaSpeak RSX Driver and ROM!
2019-06-21 TFM's latest RSX / LS3 ROM. Alternative firmware update: - make sure READY and BUSY signals are set properly in the UART / Serial Mode loop.
2019-06-24 Make alternative firmware official. Removed alternative firmware. Changes: - EEPROM PCM upload in page write mode. PCM upload is now 512 times faster. Only 3 seconds for 64 KBs. - Changes to Serial M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
2019-06-29 Update control bytes documentation and UART listener loop for documentation of serial mode.
2019-07-02 New firmware, v23. Changes: - make sure |saydate, |saytime, |saytemp are spoken even if confirmations are switched off
2019-07-03 Document &F0, <byte> sequence - to show <byte> on LEDs.
2019-07-03 Added MIDI.BAS demo program for UART MIDI with ubld.it Midi Breakout Board. New MIDI BAUD rate (BAUD rate setting 6) = 31250 supported by latest firmware v26.
2019-07-04 Update TFM LS3 ROM and RSX. He added |BIGWATCH and |LED, check it out :-)
2019-07-16 - Demo - LS3 API Call with MAXAM Assembler. Get Seconds from Real Time Clock. Requires latest Firmware (v35). - Update TFM latest LS3 ROM and RSX. - Firmware V35 - Working towards MIDI IN, and Fast G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
2019-07-17 New firmware: - fast getters: 10 us - slow getters: 10 ms - new: MEDIUM GETTERS: 50 us , control byte = &E0 - change: &D2 - &D9 RTC "get time register" API functions only work in EPSON and DECTALK mo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
2019-07-17 Changes to firmware: - version = 39. - fast getters = 10 us - slow getters = 20 ms - 10 ms more, required for stable operation of RTC.BAS program! BASIC is sloooow! - NEW: MEDIUM GETTERS = 50 us, con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
    Changes to LS300.DSK:
    - changes to RTC.BAS - no more glitches
    - new program: ASMCLOCK.BAS in MAXAM assembler demonstrate "get time" API functions and protocol w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
    [ls300hardware.h, uart-loop.c]
2019-07-17 TFM ROM / RSX LS3 driver update.
2019-08-08 LambdaSpeak 3 LS300.DSK Update: - MIDI IN Monitor in MAXAM Assembler - MIDI IN CPC Synthesizer in MAXAM Assembler
2019-08-08 LambdaSpeak 3 New Firmware Version 47: - added new UART Serial Mode 10 for MIDI IN Real Time UART Monitoring.
2019-08-24 Firmware update - SPO -> SP0 (say "vintage" instead of "S P Zero"), and MIDI / UART Monitor protocol update. Supports MIDI IN/OUT in real time now.
2019-08-27 Adding LS300 dsk for previous firmware version v47, and making firmware version v50 visible in current LS300.dsk name.
2019-08-30 Update housekeeping - new schematics and such.
2019-09-03 New firmware: - New Serial Sub-Mode 50: Realtime MIDI IN/OUT (RX / TX) working now - See MIDISYNX on LS300.dsk for MIDI IN/OUT Synth - Changes to Serial Sub-Mode 10: Soft Midi Through via UART TX
2019-09-03 Updated uart-loop.c / Serial Mode listener for documentation.
2021-03-04 Firmware v54: Amdrum Mode Exit Sequence 4 6 4 6 1 2 8 (each plus 127); and [5;250] PCM sample data clipping / limiting, for Digitracker.
2021-03-08 Chipkinru is now official LambdaSpeak 3 PCB distributor in Russia and on eBay :-)
2021-03-22 README.md - On/Off Switch Mod.
2026-09-21 Vector Head: the disc images, and how to run them
    head.dsk and head.hfe under cpc/vectorhead/, announced in the news entry,
    with a short note on running it - in particular RUN"VH and not RUN"HEAD,
    since VH.BAS is what loads the letter-to-sound engine and without it there
    is no prompt. The assembler source stays private for now.
    Claude-Session: https://claude.ai/code/session_01NYwNLJv4mWCnQH4g3MmoLD
2026-09-21 Date the Older News items, order them newest-first, fix a double period
    Every news item now carries the date it actually went up, read off the commit
    that first introduced its text rather than guessed:
    03-21-2021 LambdaSpeak 3 and Speak&SID on the same databus
    03-07-2021 chipkin.ru is manufacturing the LambdaSpeak 3 PCB
    05-30-2020 Farewell, LambdaSpeak 3 (the text says "end of May 2020")
    12-15-2019 The firmware C sources are published
    The last two were the wrong way round, so they are swapped: the section reads
    newest-first throughout now.
    Also corrects the Making Of date from 08-08-2023 to 08-07-2023. The full
    11 KB article was already there in 80205a3 on the 7th; the 8t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
