lambdamikel/LambdaSpeak3/(notices)

Notices in the files:
src/atmega644-20pu/lambdaspeak.c:
This program is free software; you can redistribute it and/or modify
it under the terms of the GNU General Public License as published by
the Free Software Foundation; either version 3 of the License, or
(at your option) any later version.
Copyright (C) 2017 - 2021 Michael Wessel
